RV-crtl/Digital-Hearing-Aid-G1/Documentation/ARCHITECTURE.md

# Integrated firmware architecture and ownership

## Product vs MCU state

This repo contains two *different* notions of mode: the group requirement uses system-wide OFF / STARTUP / NORMAL / SLEEP / FAULT, whereas the portable connectivity policy names its own M1 initialisation, M2 active, M3 source idle, M4 source fault. **M3 source idle is not electrical STOP/SLEEP mode.** Until power-transition hardware is verified, keep those state machines separate.

## Signal flow (current Nucleo integration baseline)

```mermaid
flowchart LR
 BT[Bluetooth receiver / ADC] --> DMA1[SAI1A RX DMA]
 TC[Telecoil frontend / ADC] --> DMA2[SAI2A RX DMA]
 DMA1 --> Q[Bounded PCM capture queues]
 DMA2 --> Q
 Q --> A[AudioTask: transport + DSP]
 A --> OUT[SAI2B TX DMA / amplifier]
 FSM[Portable source FSM] --> A
 CTRL[ControlTask] -->|xQueueSend control events| A
 USER[Nucleo B1] --> CTRL
 A -->|capture occupancy & errors| GUARD[Fixed-memory overload guardian]
 GUARD -->|bypass optional G1 DSP| A
```

Microphone DFSDM, USB audio, charger, custom PCB GPIO, and trained AI are **design candidates**, not running paths here.

## Concurrent responsibilities

| Owner | RTOS mechanism | Shared resource rules |
| --- | --- | --- |
| AudioTask, priority 7 | Audio buffers, time-critical route and optional DSP | Exclusive owner of profile and guardian state; never block on serial output |
| ControlTask, priority 6 | UART commands and `GroupEvent` queue writes | UI/commands send bounded events rather than changing audio state directly |
| Bluetooth supervision, priority 5 | Serial supervision/status | Bluetooth commands must not reconfigure audio DMA behind AudioTask |
| Background, CPULoadB priority 2 | Optional experiment | No real-time ownership; do not enable in production |
| HighLoad7 priority 7 | **20 s disruptive scheduler experiment** | Prohibited in normal hearing-aid use; may starve ControlTask |
| DMA IRQ callbacks | Signal capture/transfer completed | Keep short, bounded; do not do heavy DSP or blocking I/O in interrupts |

**Current limitation:** AudioTask still uses mixed queue-draining / yield logic inherited from R34. The proposed notification-driven architecture is not implemented just by drawing it here. Optimise only against measured CPU load, buffer depth and deadline data, without jeopardising playback.

## Engineering time budget

At `48,000 samples/s`, 128 frames correspond to **2.667 ms** of input time. This is a useful throughput scale, **not an assertion of the exact interrupt service deadline** because the actual buffering and DMA half/full transfers matter. Log worst-case AudioTask time, capture depth, outgoing queue depth, missed deadline counters and speaker underruns while operating the complete system.

## Truthful feature vocabulary

- **Verified:** C unit test, configuration invariant or instrumented hardware result has evidence with environment and thresholds.
- **Validated:** End-to-end user requirement tested on representative assembled hardware.
- **Pending:** Source exists but hardware behavior cannot yet be claimed.
- **Unavailable:** Schematic/PCB lacks the necessary hardware or circuit has unresolved electrical constraints.

Do not call the automatic three-level loudness heuristic 'trained TinyML.' Do not equate software PCM limiting with a safe acoustic SPL. See `Documentation/REQUIREMENTS_EVIDENCE.csv`.
