RV-crtl/Digital-Hearing-Aid-G1/Hardware/STM32_U13_PINMAP.csv

pad | stm32_pin | pcb_net
1 | VBAT_1 | +3V3
2 | PC13_2 | unconnected-(U13-PC13-Pad2)
3 | PC14_3 | unconnected-(U13-PC14-Pad3)
4 | PC15_4 | unconnected-(U13-PC15-Pad4)
5 | RCC_OSC_IN_5 | /Control, Connectivity, and Power/STM32L476RG/HSE_IN
6 | RCC_OSC_OUT_6 | /Control, Connectivity, and Power/STM32L476RG/HSE_OUT
7 | NRST_7 | /Control, Connectivity, and Power/STM32L476RG/~{RST}
8 | I2C3_SCL_8 | /Control, Connectivity, and Power/STM32L476RG/I2C3_SCL
9 | I2C3_SDA_9 | /Control, Connectivity, and Power/STM32L476RG/I2C3_SDA
10 | DFSDM1_CKOUT_10 | /Control, Connectivity, and Power/Audio Input/DFSDM_MIC.CKOUT
11 | SAI1_SD_A_11 | /Control, Connectivity, and Power/Connectivity/SAI1A_CONN.SD
12 | VSSA_12 | GNDA
13 | VDDA_13 | 3.3V_A
14 | PA0_14 | /Control, Connectivity, and Power/STM32L476RG/ROTENC_OUT.A
15 | PA1_15 | /Control, Connectivity, and Power/STM32L476RG/ROTENC_OUT.B
16 | USART2_TX_16 | /Control, Connectivity, and Power/STM32L476RG/USART_TX
17 | USART2_RX_17 | /Control, Connectivity, and Power/STM32L476RG/USART_RX
18 | VSS_18 | GND
19 | VDD_19 | +3V3
20 | PA4_20 | unconnected-(U13-PA4-Pad20)
21 | PA5_21 | unconnected-(U13-PA5-Pad21)
22 | PA6_22 | unconnected-(U13-PA6-Pad22)
23 | PA7_23 | unconnected-(U13-PA7-Pad23)
24 | USART3_TX_24 | /Control, Connectivity, and Power/STM32L476RG/USART3_TX
25 | USART3_RX_25 | /Control, Connectivity, and Power/STM32L476RG/USART3_RX
26 | USART3_CK_26 | /Control, Connectivity, and Power/STM32L476RG/USART3_CK
27 | PB1_27 | unconnected-(U13-PB1-Pad27)
28 | PB2_28 | unconnected-(U13-PB2-Pad28)
29 | SAI1_SCK_A_29 | /Control, Connectivity, and Power/Connectivity/SAI1A_CONN.SCK
30 | PB11_30 | unconnected-(U13-PB11-Pad30)
31 | VSS_31 | GND
32 | VDD_32 | +3V3
33 | SAI2_FS_A_33 | /Control, Connectivity, and Power/Connectivity/SAI1A_CONN.FS
34 | SAI2_SCK_A_34 | /Control, Connectivity, and Power/Connectivity/SAI1A_CONN.SCK
35 | DFSDM1_DATIN2_35 | /Control, Connectivity, and Power/Audio Input/DFSDM_MIC.SD
36 | SAI2_SD_A_36 | /Control, Connectivity, and Power/Connectivity/SAI_CONN_SD
37 | PC6_37 | unconnected-(U13-PC6-Pad37)
38 | PC7_38 | unconnected-(U13-PC7-Pad38)
39 | PC8_39 | unconnected-(U13-PC8-Pad39)
40 | PC9_40 | unconnected-(U13-PC9-Pad40)
41 | PA8_41 | unconnected-(U13-PA8-Pad41)
42 | USART1_TX_42 | /Control, Connectivity, and Power/Connectivity/UART_BT.TX
43 | USART1_RX_43 | /Control, Connectivity, and Power/Connectivity/UART_BT.RX
44 | USB_OTG_FS_DM_44 | /Control, Connectivity, and Power/STM32L476RG/USB_D-
45 | USB_OTG_FS_DP_45 | /Control, Connectivity, and Power/STM32L476RG/USB_D+
46 | SYS_JTMS-SWDIO_46 | /Control, Connectivity, and Power/STM32L476RG/SWDIO
47 | VSS_47 | GND
48 | VDDUSB_48 | +3V3
49 | SYS_JTCK-SWCLK_49 | /Control, Connectivity, and Power/STM32L476RG/SWCLK
50 | SAI2_FS_B_50 | /Control, Connectivity, and Power/Output/SAI_SPEAKER.FS
51 | SAI2_SCK_B_51 | /Control, Connectivity, and Power/Output/SAI_SPEAKER.SCK
52 | PC11_52 | unconnected-(U13-PC11-Pad52)
53 | SAI2_SD_B_53 | /Control, Connectivity, and Power/Output/SAI_SPEAKER.SD
54 | PD2_54 | unconnected-(U13-PD2-Pad54)
55 | SYS_JTDO-SWO_55 | /Control, Connectivity, and Power/STM32L476RG/SWO
56 | PB4_56 | unconnected-(U13-PB4-Pad56)
57 | PB5_57 | unconnected-(U13-PB5-Pad57)
58 | I2C1_SCL_58 | /Control, Connectivity, and Power/STM32L476RG/I2C_CAPTO.SCL
59 | I2C1_SDA_59 | /Control, Connectivity, and Power/STM32L476RG/I2C_CAPTO.SDA
60 | BOOT0_60 | /Control, Connectivity, and Power/STM32L476RG/BOOT0
61 | SAI1_MCLK_A_61 | /Control, Connectivity, and Power/Connectivity/SAI1A_CONN.MCLK
62 | SAI1_FS_A_62 | /Control, Connectivity, and Power/Connectivity/SAI1A_CONN.FS
63 | VSS_63 | GND
64 | VDD_64 | +3V3
