RV-crtl/Digital-Hearing-Aid-G1/docs/assets/g1-assembly.3mf

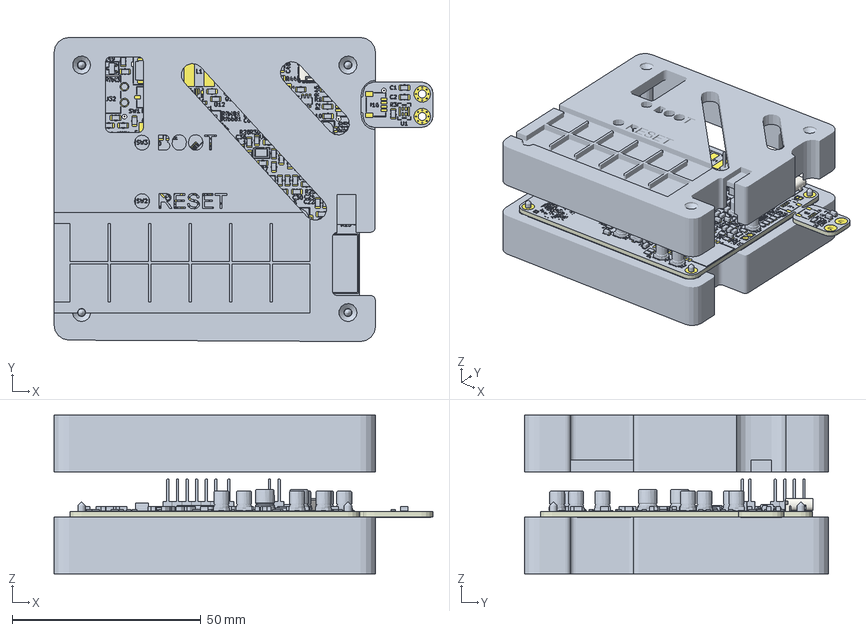
[picture p1: CAD file, 2026-10-31]
docs/assets/g1-assembly.3mf
100.3 x 80.5 x 42.0 mm
Imported_131
Imported_1628
Imported_557
Imported_944
Imported_29
Imported_132
Imported_481
Imported_34
Imported_765
Imported_28
Imported_491
Imported_01
Imported_1682
Imported_1713
Imported_257
Imported_02
Imported_247
Imported_283
Imported_1084
Imported_04
Imported_03
Imported_278
Imported_113
Imported_1071
Imported_1185
Imported_708
Imported_39
Imported_1561
Imported_148
Imported_58
Imported_970
Imported_35
Imported_1033
Imported_586
Imported_297
Imported_14
Imported_05
Imported_06
Imported_870
Imported_839
Imported_42
Imported_1390
Imported_1015
Imported_486
Imported_1188
Imported_36
Imported_75
Imported_252
Imported_1246
Imported_1668
Imported_97
Imported_07
Imported_376
Imported_1243
Imported_907
Imported_20
Imported_1304
Imported_61
Imported_303
Imported_1585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
