RV-crtl/Digital-Hearing-Aid-G1/RESULTS_LOCATION.txt

/mnt/data/work_r34/261013-Individual_Demonstration_Connectivity/RESULTS_R26
