RV-crtl/Digital-Hearing-Aid-G1/Hardware/Original_KiCad/260510-Digital_hearing_aid.kicad_pcb

## KiCad design Hardware/Original_KiCad/260510-Digital_hearing_aid.kicad_pcb (2026-10-15)

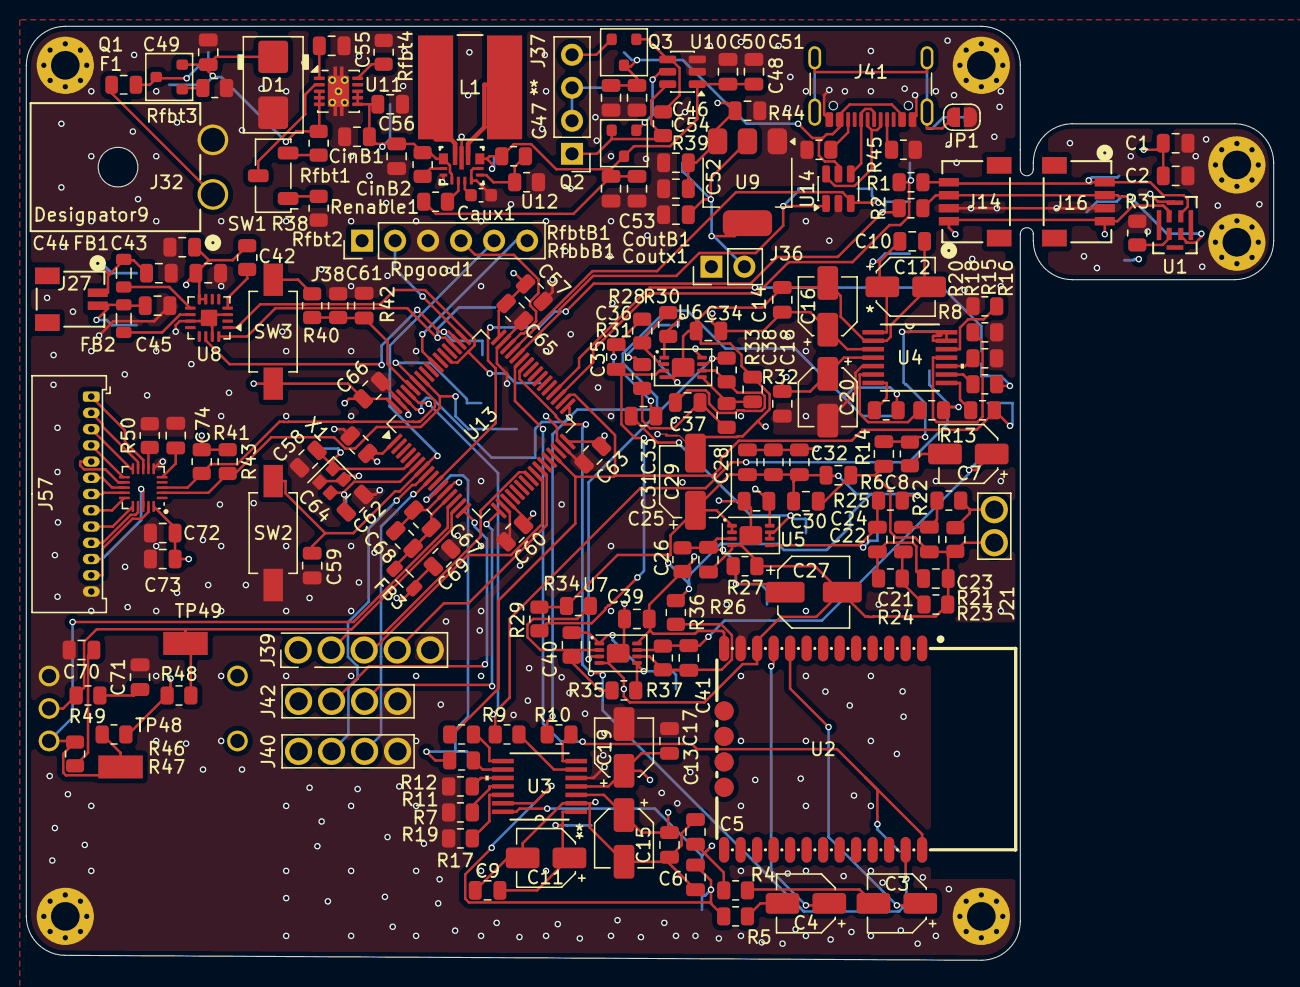
[picture p2: board 260510-Digital_hearing_aid.kicad_pcb from above]

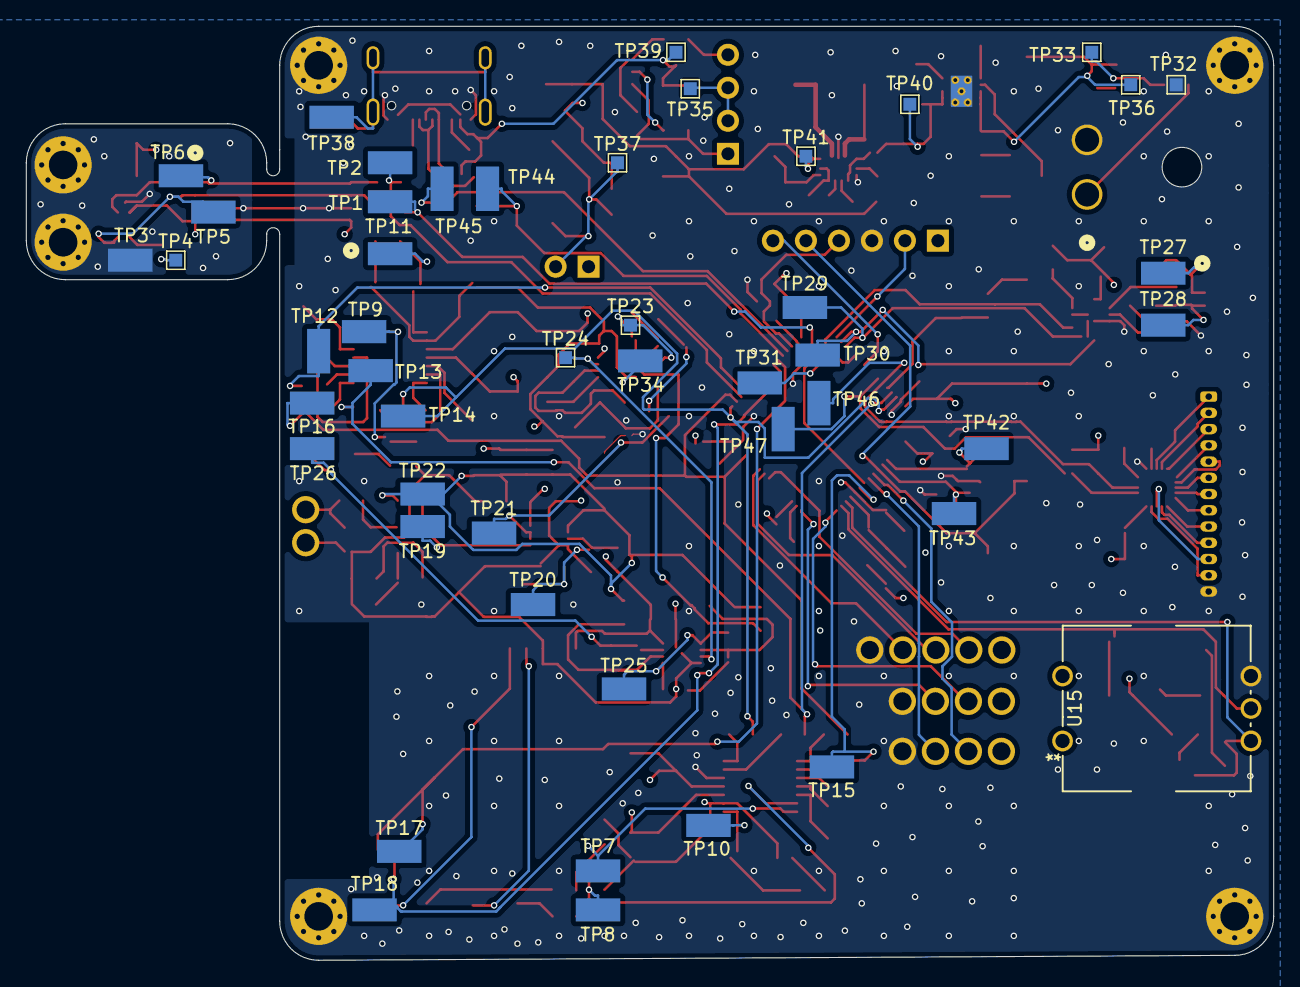
[picture p3: board 260510-Digital_hearing_aid.kicad_pcb from below]

Board: 4 copper layers, 96.0 x 71.9 mm, 236 parts (48 on the bottom side), 134 nets.

Parts:
C1, C42, C46, C50, C57: 10u; C_0805_2012Metric
C2, C9, C10, C13, C14, C17, C18, C25, C26, C28, C30, C31, C32, C33, C34, C39, C43, C47, C49, C51, C54, C59, C60, C61, C63, C64, C65, C66, C72, C73, C74: 100n; C_0805_2012Metric
C3, C4, C7, C11, C12, C15, C16, C19, C20: 10u; CP_Elec_4x5.3
C5, C6, C8: 100p; C_0805_2012Metric
C21, C44, C45: 470p; C_0805_2012Metric
C22: 33n; C_0805_2012Metric
C23, C55: 1n; C_0805_2012Metric
C24, C56, C68, C69: 1u; C_0805_2012Metric
C27, C29: 10u; CP_Elec_5x5.7
C35, C36: 22n; C_0805_2012Metric
C37: 3n; C_0805_2012Metric
C38: 1n5; C_0805_2012Metric
C40, C41: 22p; C_0805_2012Metric
C48, C52: 22u; C_0805_2012Metric
C53: 47u; C_0805_2012Metric
C58, C62: 10p; C_0805_2012Metric
C67, C70, C71: 10n; C_0805_2012Metric
Caux1: 100n; C_0603_1608Metric
CinB1, CinB2: 22u; C_0805_2012Metric
CoutB1: 22u; C_0805_2012Metric
Coutx1: 10u; C_0805_2012Metric
D1: SMBJ8.0A; D_SMB
F1: Fuse; Fuse_0805_2012Metric
FB1, FB2, FB3: 120R @100MHz; L_0805_2012Metric
H1, H2, H3, H4, H5, H6: MountingHole_Pad; MountingHole_2.2mm_M2_Pad_Via
J14, J16: Microphone Connectors; CONN_SM04B-SRSS-TB_JST
J21: Telecoil; PinHeader_01x02_P2.54mm_Vertical_THT_D1.4mm
J27: Bone Conductor Connector; CONN_SM02B-SRSS-TB_JST
J32: 1726480102; CONN_SD-172648-0000_02_MOL
J36: Conn_01x02_Pin; PinHeader_1x02_P2.54mm_Vertical
J37: Conn_01x04_Pin; PinHeader_1x04_P2.54mm_Vertical
J38: ST_LINK; PinHeader_1x06_P2.54mm_Vertical
J39: Number of Lines; PinHeader_01x05_P2.54mm_Vertical_THT_D1.4mm
J40, J42: Impedance @ Frequency; PinHeader_01x04_P2.54mm_Vertical_THT_D1.4mm
J41: USB_C_Receptacle_USB2.0_16P; USB_C_Receptacle_GCT_USB4105-xx-A_16P_TopMnt_Horizontal
J57: Conn_01x13; Molex_PicoBlade_53048-1310_1x13_P1.25mm_Horizontal
JP1: SolderJumper_2_Open; SolderJumper-2_P1.3mm_Open_RoundedPad1.0x1.5mm
L1: 1u5; IND_BOURNS_SDR0805
NT1: NetTie_2; Net_Tie_0.16mm_6mil
Q1, Q2, Q3: AO3419; SOT-23
R1, R2, R30, R33: 33R; R_0805_2012Metric
R3, R4, R5, R6, R7, R8, R17, R18, R19, R20, R24, R34, R36, R40, R41, R43, R46, R47, R48, R49: 10k; R_0805_2012Metric
R9, R10, R11, R12, R13, R14, R15, R16: 100R; R_0805_2012Metric
R21, R25, R38: 100k; R_0805_2012Metric
R22: 1k; R_0805_2012Metric
R23, R35, R37: 47k; R_0805_2012Metric
R26, R27: 22k; R_0805_2012Metric
R28: 21k5; R_0805_2012Metric
R29: 43k; R_0805_2012Metric
R31, R32: 11k7; R_0805_2012Metric
R39: 470k; R_0805_2012Metric
R42: 220R; R_0805_2012Metric
R44, R45: 5k1; R_0805_2012Metric
R50: 75k; R_0805_2012Metric
Renable1: 10k; R_0805_2012Metric
RfbbB1: 100k; R_0805_2012Metric
Rfbt1: 301k; R_0805_2012Metric
Rfbt2, Rfbt3: 100k; R_0805_2012Metric
Rfbt4: 45k3; R_0805_2012Metric
RfbtB1: 523k; R_0805_2012Metric
Rpgood1: 100k; R_0805_2012Metric
SW1: SW_Nidec_CAS-120TA; Nidec_Copal_CAS-120A
SW2, SW3: Switch_Tactile_CnK; Button_CnK_PTS636.0_6x3.5mm
TP1: MicClk1; KEYSTONE_5015
TP2: MicSd1; KEYSTONE_5015
TP3: GND1; KEYSTONE_5015
TP4: Ext3V0; TestPoint_Pad_1.0x1.0mm
TP5: MicClk2; KEYSTONE_5015
TP6: MicSd2; KEYSTONE_5015
TP7: VinR1; KEYSTONE_5015
TP8: VinL1; KEYSTONE_5015
TP9: TcVin1; KEYSTONE_5015
TP10: BtVref_adc1; KEYSTONE_5015
TP11: TcVref_adc1; KEYSTONE_5015
TP12: Sai2SD1; KEYSTONE_5015
TP13: SaiMCLK1; KEYSTONE_5015
TP14: SaiFS1; KEYSTONE_5015
TP15: SaiSD1; KEYSTONE_5015
TP16: SaiSCK1; KEYSTONE_5015
TP17: BtRx1; KEYSTONE_5015
TP18: BtTx1; KEYSTONE_5015
TP19: BuffIn1; KEYSTONE_5015
TP20: Buff+1; KEYSTONE_5015
TP21: BuffOut1; KEYSTONE_5015
TP22: TcVref1; KEYSTONE_5015
TP23: FiltIn1; TestPoint_Pad_1.0x1.0mm
TP24: FiltOut1; TestPoint_Pad_1.0x1.0mm
TP25: TcAmpIn1; KEYSTONE_5015
TP26: TcAmpOut1; KEYSTONE_5015
TP27: Spk+1; KEYSTONE_5015
TP28: Spk-1; KEYSTONE_5015
TP29: SpkCK1; KEYSTONE_5015
TP30: SpkFS1; KEYSTONE_5015
TP31: SpkSD1; KEYSTONE_5015
TP32: BATT-; TestPoint_Pad_1.0x1.0mm
TP33: BATT+; TestPoint_Pad_1.0x1.0mm
TP34: GndA1; KEYSTONE_5015
TP35: 5V; TestPoint_Pad_1.0x1.0mm
TP36: TpsVin1; TestPoint_Pad_1.0x1.0mm
TP37: 3V0; TestPoint_Pad_1.0x1.0mm
TP38: ChassGnd1; KEYSTONE_5015
TP39: VBus1; TestPoint_Pad_1.0x1.0mm
TP40: TpsOut1; TestPoint_Pad_1.0x1.0mm
TP41: BATT5V+1; TestPoint_Pad_1.0x1.0mm
TP42: HseIN1; KEYSTONE_5015
TP43: HseOUT1; KEYSTONE_5015
TP44: UsbD-1; KEYSTONE_5015
TP45: UsbD+1; KEYSTONE_5015
TP46: CaptoSDA1; KEYSTONE_5015
TP47: CaptoSCL1; KEYSTONE_5015
TP48: EncA1; KEYSTONE_5015
TP49: EncB1; KEYSTONE_5015
U1: MP34DT05TR-A; MP34DT05TR-A_STM
U2: DFR0781; COMM-SMD_L23.0-W15.5-P1.27_DFR0781
U3, U4: PCM1808PWR; PW14
U5, U6, U7: MCP6232T-E-MNY; DFN-8-1EP_3x2mm_P0.5mm_EP1.75x1.45mm
U8: MAX98357A; TQFN-16-1EP_3x3mm_P0.5mm_EP1.23x1.23mm
U9: AMS1117-3.3; SOT-223-3_TabPin2
U10: LTC4412ES6#TRMPBF; TSOT-23-6
U11: TPS259260DRCR; VSON-10_Custom
U12: TPS63070RNMR; RNM0015A
U13: STM32L476RGTx; LQFP-64_10x10mm_P0.5mm
U14: USBLC6-2SC6; SOT-23-6
U15: PEC11R-4215F-S0024; TO_215F-S0024
U16: MPR121QR2; QFN-20_3x3mm_P0.4mm
X1: 16MHz; Crystal_SMD_SeikoEpson_FA128-4Pin_2.0x1.6mm

Connections:
3.3V_A: C67.1, C68.1, FB3.1, U13.13 (VDDA)
+3V3: C1.1, C2.1, C17.1, C18.1, C19.1, C20.1, C57.1, C60.1, C63.1, C64.1, C65.1, C66.1, C69.1, C72.1, C73.2, FB3.2, J14.1, J16.4, J36.1, J38.1, J39.1, J40.1, J42.1, R41.1, R43.1, SW3.2, TP4.1 (1_1), U1.1 (VDD), U3.4 (VDD), U4.4 (VDD), U13.1 (VBAT), U13.19 (VDD), U13.32 (VDD), U13.48 (VDDUSB), U13.64 (VDD), U16.20 (VDD)
+5V: C13.1, C14.1, C15.1, C16.1, C25.1, C34.1, C39.1, C42.1, C43.1, C48.2, C53.1, C54.2, J37.2, J37.3, R26.2, R38.1, R46.1, R48.1, TP35.1 (1_1), U2.13 (VCC), U3.3 (VCC), U4.3 (VCC), U5.8 (V+), U6.8 (V+), U7.8 (V+), U8.7 (VDD), U8.8 (VDD), U9.3 (VI)
+5VBAT: C50.1, C51.2, CoutB1.1, Coutx1.1, Q2.3 (D), RfbtB1.1, Rpgood1.1, TP41.1 (1_1), U10.1 (VIN), U12.7 (VOUT), U12.8 (VOUT)
/Control, Connectivity, and Power/Audio Input/DFSDM_CLK: J14.3, J16.2, R2.2, TP5.TP, U1.3 (CLK)
/Control, Connectivity, and Power/Audio Input/DFSDM_DOUT: J14.4, J16.1, R1.2, TP6.TP, U1.4 (DOUT)
/Control, Connectivity, and Power/Audio Input/DFSDM_MIC.CKOUT: R2.1, TP1.TP, U13.10 (DFSDM1_CKOUT)
/Control, Connectivity, and Power/Audio Input/DFSDM_MIC.SD: R1.1, TP2.TP, U13.35 (DFSDM1_DATIN2)
/Control, Connectivity, and Power/Connectivity/Analog Frontend/Active Bandpass 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: C35.1, TP21.TP, U5.6 (-), U5.7
/Control, Connectivity, and Power/Connectivity/Analog Frontend/Active Bandpass 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: R33.1, TP24.1 (1_1), U6.7, U7.3 (+)
/Control, Connectivity, and Power/Connectivity/Analog Frontend/TC+: J21.1, R21.2, R22.2
/Control, Connectivity, and Power/Connectivity/Analog Frontend/TC_DACO: C7.1, C41.2, R37.2, TP26.TP, U7.7
/Control, Connectivity, and Power/Connectivity/Analog Frontend/Telecoil Buffer 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: C24.2, R25.2, TP19.TP, U5.5 (+)
/Control, Connectivity, and Power/Connectivity/BT_BCK: R12.1, U3.8 (BCK)
/Control, Connectivity, and Power/Connectivity/BT_DACL: C4.1, U2.10 (DACL)
/Control, Connectivity, and Power/Connectivity/BT_DACR: C3.1, U2.9 (DACR)
/Control, Connectivity, and Power/Connectivity/BT_DOUT: R11.1, U3.9 (DOUT)
/Control, Connectivity, and Power/Connectivity/BT_FMT: R17.1, U3.12 (FMT)
/Control, Connectivity, and Power/Connectivity/BT_LRCK: R10.1, U3.7 (LRCK)
/Control, Connectivity, and Power/Connectivity/BT_MD0: R7.1, U3.10 (MD0)
/Control, Connectivity, and Power/Connectivity/BT_MD1: R19.1, U3.11 (MD1)
/Control, Connectivity, and Power/Connectivity/BT_SCKI: R9.1, U3.6 (SCKI)
/Control, Connectivity, and Power/Connectivity/BT_VINL: C6.1, R5.2, TP8.TP, U3.13 (VINL)
/Control, Connectivity, and Power/Connectivity/BT_VINR: C5.1, R4.2, TP7.TP, U3.14 (VINR)
/Control, Connectivity, and Power/Connectivity/BT_VREF: C9.1, C11.1, TP10.TP, U3.1 (VREF)
/Control, Connectivity, and Power/Connectivity/SAI1A_CONN.FS: R10.2, R14.2, TP14.TP, U13.33 (SAI2_FS_A), U13.62 (SAI1_FS_A)
/Control, Connectivity, and Power/Connectivity/SAI1A_CONN.MCLK: R9.2, R13.2, TP13.TP, U13.61 (SAI1_MCLK_A)
/Control, Connectivity, and Power/Connectivity/SAI1A_CONN.SCK: R12.2, R16.2, TP16.TP, U13.29 (SAI1_SCK_A), U13.34 (SAI2_SCK_A)
/Control, Connectivity, and Power/Connectivity/SAI1A_CONN.SD: R11.2, TP15.TP, U13.11 (SAI1_SD_A)
/Control, Connectivity, and Power/Connectivity/SAI_CONN_SD: R15.2, TP12.TP, U13.36 (SAI2_SD_A)
/Control, Connectivity, and Power/Connectivity/TC_BCK: R16.1, U4.8 (BCK)
/Control, Connectivity, and Power/Connectivity/TC_DOUT: R15.1, U4.9 (DOUT)
/Control, Connectivity, and Power/Connectivity/TC_FMT: R18.1, U4.12 (FMT)
/Control, Connectivity, and Power/Connectivity/TC_LRCK: R14.1, U4.7 (LRCK)
/Control, Connectivity, and Power/Connectivity/TC_MD0: R8.1, U4.10 (MD0)
/Control, Connectivity, and Power/Connectivity/TC_MD1: R20.1, U4.11 (MD1)
/Control, Connectivity, and Power/Connectivity/TC_SCKI: R13.1, U4.6 (SCKI)
/Control, Connectivity, and Power/Connectivity/TC_VIN: C8.1, R6.2, TP9.TP, U4.13 (VINL), U4.14 (VINR)
/Control, Connectivity, and Power/Connectivity/TC_VREF: C10.1, C12.1, TP11.TP, U4.1 (VREF)
/Control, Connectivity, and Power/Connectivity/UART_BT.RX: TP17.TP, U2.26 (PB0/TX), U13.43 (USART1_RX)
/Control, Connectivity, and Power/Connectivity/UART_BT.TX: TP18.TP, U2.25 (PB1/RX), U13.42 (USART1_TX)
/Control, Connectivity, and Power/Output/OUT+: FB1.1, U8.9 (OUTP)
/Control, Connectivity, and Power/Output/OUT-: FB2.1, U8.10 (OUTN)
/Control, Connectivity, and Power/Output/SAI_SPEAKER.FS: TP30.TP, U8.14 (LRCLK), U13.50 (SAI2_FS_B)
/Control, Connectivity, and Power/Output/SAI_SPEAKER.SCK: TP29.TP, U8.16 (BCLK), U13.51 (SAI2_SCK_B)
/Control, Connectivity, and Power/Output/SAI_SPEAKER.SD: TP31.TP, U8.1 (DIN), U13.53 (SAI2_SD_B)
/Control, Connectivity, and Power/Output/SPEAKER+: C44.2, FB1.2, J27.1, TP27.TP
/Control, Connectivity, and Power/Output/SPEAKER-: C45.2, FB2.2, J27.2, TP28.TP
/Control, Connectivity, and Power/Output/~SD_MODE: R38.2, U8.4 (~SD_MODE)
/Control, Connectivity, and Power/Power/EFUSE_EN: SW1.2 (B), U11.2 (EN/UVLO)
/Control, Connectivity, and Power/Power/VBATT_PROT: C49.1, D1.1 (K), Q1.2 (S), Rfbt1.1, TP36.1 (1_1), U11.3 (VIN), U11.4 (VIN), U11.5 (VIN)
/Control, Connectivity, and Power/STM32L476RG/BOOT0: C61.2, R40.1, R42.1, U13.60 (BOOT0)
/Control, Connectivity, and Power/STM32L476RG/HSE_IN: C58.1, TP42.TP, U13.5 (RCC_OSC_IN), X1.1
/Control, Connectivity, and Power/STM32L476RG/HSE_OUT: C62.2, TP43.TP, U13.6 (RCC_OSC_OUT), X1.3
/Control, Connectivity, and Power/STM32L476RG/I2C3_SCL: J40.2, U13.8 (I2C3_SCL)
/Control, Connectivity, and Power/STM32L476RG/I2C3_SDA: J40.3, U13.9 (I2C3_SDA)
/Control, Connectivity, and Power/STM32L476RG/I2C_CAPTO.SCL: R43.2, TP47.TP, U13.58 (I2C1_SCL), U16.2 (SCL)
/Control, Connectivity, and Power/STM32L476RG/I2C_CAPTO.SDA: R41.2, TP46.TP, U13.59 (I2C1_SDA), U16.3 (SDA)
/Control, Connectivity, and Power/STM32L476RG/ROTENC_OUT.A: R46.2, R47.2, TP48.TP, U13.14 (PA0), U15.A
/Control, Connectivity, and Power/STM32L476RG/ROTENC_OUT.B: R48.2, R49.2, TP49.TP, U13.15 (PA1), U15.B
/Control, Connectivity, and Power/STM32L476RG/SWCLK: J38.2, U13.49 (SYS_JTCK-SWCLK)
/Control, Connectivity, and Power/STM32L476RG/SWDIO: J38.4, U13.46 (SYS_JTMS-SWDIO)
/Control, Connectivity, and Power/STM32L476RG/SWO: J38.6, U13.55 (SYS_JTDO-SWO)
/Control, Connectivity, and Power/STM32L476RG/USART3_CK: J39.4, U13.26 (USART3_CK)
/Control, Connectivity, and Power/STM32L476RG/USART3_RX: J39.3, U13.25 (USART3_RX)
/Control, Connectivity, and Power/STM32L476RG/USART3_TX: J39.2, U13.24 (USART3_TX)
/Control, Connectivity, and Power/STM32L476RG/USART_RX: J42.3, U13.17 (USART2_RX)
/Control, Connectivity, and Power/STM32L476RG/USART_TX: J42.2, U13.16 (USART2_TX)
/Control, Connectivity, and Power/STM32L476RG/USBC_CC1: J41.A5 (CC1), R45.1
/Control, Connectivity, and Power/STM32L476RG/USBC_CC2: J41.B5 (CC2), R44.1
/Control, Connectivity, and Power/STM32L476RG/USBC_D+: J41.A6 (D+), J41.B6 (D+), U14.4 (I/O2)
/Control, Connectivity, and Power/STM32L476RG/USBC_D-: J41.A7 (D-), J41.B7 (D-), U14.6 (I/O1)
/Control, Connectivity, and Power/STM32L476RG/USB_D+: TP45.TP, U13.45 (USB_OTG_FS_DP), U14.3 (I/O2)
/Control, Connectivity, and Power/STM32L476RG/USB_D-: TP44.TP, U13.44 (USB_OTG_FS_DM), U14.1 (I/O1)
/Control, Connectivity, and Power/STM32L476RG/~RST: C59.1, J38.5, SW2.1, U13.7 (NRST)
/Control, Connectivity, and Power/User Interface/CAPTO_REXT: R50.1, U16.7 (REXT)
/Control, Connectivity, and Power/User Interface/CAPTO_VREG: C74.2, U16.5 (VREG)
Chassis GND: J41.SH (SHIELD), JP1.2 (B), TP38.TP
GND: C1.2, C2.2, C17.2, C18.2, C19.2, C20.2, C42.2, C43.2, C44.1, C45.1, C46.2, C47.1, C48.1, C49.2, C50.2, C51.1, C52.2, C53.2, C54.1, C55.2, C56.2, C57.2, C58.2, C59.2, C60.2, C61.1, C62.1, C63.2, C64.2, C65.2, C66.2, C69.2, C70.2, C71.2, C72.2, C73.1, C74.1, Caux1.2, CinB1.2, CinB2.2, CoutB1.2, Coutx1.2, D1.2 (A), H1.1 (1_1), H2.1 (1_1), H3.1 (1_1), H4.1 (1_1), H5.1 (1_1), H6.1 (1_1), J14.2, J16.3, J32.2, J38.3, J39.5, J40.4, J41.A1 (GND), J41.A12 (GND), J41.B1 (GND), J41.B12 (GND), J42.4, J57.13, JP1.1 (A), NT1.1, R3.2, R7.2, R8.2, R17.2, R18.2, R19.2, R20.2, R40.2, R44.2, R45.2, R50.2, RfbbB1.2, Rfbt2.2, Rfbt3.2, Rfbt4.2, SW2.2, TP3.TP, TP32.1 (1_1), U1.5 (GND), U2.12 (GND), U3.5 (DGND), U4.5 (DGND), U8.3 (GND), U8.11 (GND), U8.15 (GND), U8.17 (PAD), U9.1 (GND), U10.2 (GND), U10.3 (CTL), U11.11 (GND), U12.4 (GND), U12.6 (FB2), U12.10 (PGND), U12.15 (VSEL), U13.18 (VSS), U13.31 (VSS), U13.47 (VSS), U13.63 (VSS), U14.2 (GND), U15.C, U16.6 (VSS), X1.2, X1.4
GNDA: C5.2, C6.2, C8.2, C9.2, C10.2, C11.2, C12.2, C13.2, C14.2, C15.2, C16.2, C21.2, C23.2, C25.2, C26.2, C27.2, C28.2, C29.2, C30.2, C31.2, C32.2, C33.2, C34.2, C38.1, C39.2, C67.2, C68.2, J21.2, NT1.2, R21.1, R23.2, R27.1, TP34.TP, U2.11 (SGND), U3.2 (AGND), U4.2 (AGND), U5.4 (V-), U5.9 (PAD), U6.4 (V-), U6.9 (PAD), U7.4 (V-), U7.9 (PAD), U13.12 (VSSA)
unnamed: C3.2, R4.1
unnamed: C4.2, R5.1
unnamed: C7.2, R6.1
unnamed: C21.1, C22.1, R22.1
unnamed: C22.2, R23.1, R24.2
unnamed: C23.1, C24.1, R24.1
unnamed: C35.2, C36.1, R28.2
unnamed: C37.1, R31.1, R32.2
unnamed: C70.1, R47.1
unnamed: C71.1, R49.1
unnamed: F1.1, J32.1
unnamed: C52.1, J36.2, TP37.1 (1_1), U9.2 (VO)
unnamed: J37.1, Q2.2 (S), R39.1, U10.6 (SENSE)
unnamed: J37.4, Q3.2 (S)
unnamed: J57.1, U16.8 (ELE0)
unnamed: J57.2, U16.9 (ELE1)
unnamed: J57.3, U16.10 (ELE2)
unnamed: J57.4, U16.11 (ELE3)
unnamed: J57.5, U16.12 (LED0/ELE4)
unnamed: J57.6, U16.13 (LED1/ELE5)
unnamed: J57.7, U16.14 (LED2/ELE6)
unnamed: J57.8, U16.15 (LED3/ELE7)
unnamed: J57.9, U16.16 (LED4/ELE8)
unnamed: J57.10, U16.17 (LED5/ELE9)
unnamed: J57.11, U16.18 (LED6/ELE10)
unnamed: J57.12, U16.19 (LED7/ELE11)
unnamed: F1.2, Q1.3 (D), TP33.1 (1_1)
unnamed: Q1.1 (G), Rfbt3.1
unnamed: Q2.1 (G), U10.5 (GATE)
unnamed: Q3.1 (G), R39.2, U10.4 (STAT)
unnamed: R30.1, R31.2, TP23.1 (1_1), U6.1
unnamed: R42.2, SW3.1
unnamed: Rfbt1.2, SW1.3 (A)
unnamed: Rfbt2.1, SW1.1 (C)
unnamed: R3.1, U1.2 (LR)
unnamed: C26.1, C27.1, R26.1, R27.2, TP20.TP, U5.3 (+)
unnamed: C36.2, R29.2, U6.3 (+)
unnamed: R28.1, R30.2, U6.2 (-)
unnamed: C38.2, R32.1, U6.5 (+)
unnamed: C37.2, R33.2, U6.6 (-)
unnamed: C40.1, R34.2, R35.1, U7.2 (-)
unnamed: C40.2, R35.2, TP25.TP, U7.1, U7.5 (+)
unnamed: C41.1, R36.2, R37.1, U7.6 (-)
unnamed: Rfbt4.1, U11.10 (ILIM)
unnamed: C55.1, U11.1 (dV/dT)
unnamed: Renable1.2, U12.14 (EN)
unnamed: RfbbB1.1, RfbtB1.2, U12.5 (FB)
unnamed: L1.2, U12.11 (L1)
unnamed: L1.1, U12.9 (L2)
unnamed: Rpgood1.2, U12.2 (PG)
unnamed: C56.1, CinB1.1, CinB2.1, Renable1.1, TP40.1 (1_1), U11.6 (OUT), U11.7 (OUT), U11.8 (OUT), U12.1 (PS_SYNC), U12.12 (VIN), U12.13 (VIN)
unnamed: Caux1.1, U12.3 (VAUX)
TCOIL_VREF: C28.1, C29.1, C30.1, C31.1, C32.1, C33.1, R25.1, R29.1, R34.1, R36.1, TP22.TP, U5.1, U5.2 (-)
VBUS: C46.1, C47.2, J41.A4 (VBUS), J41.A9 (VBUS), J41.B4 (VBUS), J41.B9 (VBUS), Q3.3 (D), TP39.1 (1_1), U14.5 (VBUS)
