RV-crtl/Digital-Hearing-Aid-G1/References/GroupMemberPrototypes/I2C_Touch_Probe/Core/Inc/main.h

#define B1_Pin GPIO_PIN_13
#define B1_GPIO_Port GPIOC
#define ENC_A_Pin GPIO_PIN_0
#define ENC_A_GPIO_Port GPIOA
#define ENC_A_EXTI_IRQn EXTI0_IRQn
#define ENC_B_Pin GPIO_PIN_1
#define ENC_B_GPIO_Port GPIOA
#define ENC_B_EXTI_IRQn EXTI1_IRQn
#define USART_TX_Pin GPIO_PIN_2
#define USART_TX_GPIO_Port GPIOA
#define USART_RX_Pin GPIO_PIN_3
#define USART_RX_GPIO_Port GPIOA
#define LD2_Pin GPIO_PIN_5
#define LD2_GPIO_Port GPIOA
#define TMS_Pin GPIO_PIN_13
#define TMS_GPIO_Port GPIOA
#define TCK_Pin GPIO_PIN_14
#define TCK_GPIO_Port GPIOA
#define SWO_Pin GPIO_PIN_3
#define SWO_GPIO_Port GPIOB
