RV-crtl/Digital-Hearing-Aid-G1/References/GroupMemberPrototypes/I2C_Touch_Probe/Core/Src/main.c

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

/* Includes ------------------------------------------------------------------*/
#include "main.h"

/* USER CODE BEGIN Includes */

#include <stdio.h>

/* USER CODE END Includes */


I2C_HandleTypeDef hi2c1;

UART_HandleTypeDef huart2;


void SystemClock_Config(void);

static void MX_GPIO_Init(void);
static void MX_USART2_UART_Init(void);
static void MX_I2C1_Init(void);

/* USER CODE BEGIN PFP */

void I2C_Scan(void);

/* USER CODE END PFP */

/* USER CODE BEGIN 0 */


/* ============================================================
 * PRINTF -> USART2
 * ============================================================ */

int __io_putchar(int ch)
{
    HAL_UART_Transmit(&huart2,
                      (uint8_t *)&ch,
                      1,
                      HAL_MAX_DELAY);

    return ch;
}


/* ============================================================
 * I2C BUS SCANNER
 * ============================================================ */

void I2C_Scan(void)
{
    HAL_StatusTypeDef result;

    uint8_t devices_found = 0;


    printf("\r\n");
    printf("========================================\r\n");
    printf("            I2C BUS SCANNER\r\n");
    printf("========================================\r\n");

    printf("Scanning addresses 0x08 - 0x77...\r\n");
    printf("\r\n");


    /*
     * Scan the normal 7-bit I2C address range.
     *
     * HAL_I2C_IsDeviceReady() expects the 7-bit
     * address shifted left by one bit.
     */

    for (uint8_t address = 0x08;
         address <= 0x77;
         address++)
    {
        result = HAL_I2C_IsDeviceReady(
                    &hi2c1,
                    (uint16_t)(address << 1),
                    3,
                    20);


        if (result == HAL_OK)
        {
            printf(">>> DEVICE FOUND AT 0x%02X <<<\r\n",
                   address);

            devices_found++;
        }
    }


    printf("\r\n");
    printf("----------------------------------------\r\n");


    if (devices_found == 0)
    {
        printf("NO I2C DEVICES FOUND\r\n");
    }

    else
    {
        printf("SCAN COMPLETE\r\n");

        printf("%u DEVICE(S) FOUND\r\n",
               devices_found);
    }


    printf("----------------------------------------\r\n");
}


/* USER CODE END 0 */


/**
  * @brief  The application entry point.
  * @retval int
  */
int main(void)
{

    /* MCU Configuration--------------------------------------------------------*/


    /*
     * Reset of all peripherals,
     * Initializes Flash interface and SysTick.
     */

    HAL_Init();


    /* Configure the system clock */

    SystemClock_Config();


    /* Initialize all configured peripherals */

    MX_GPIO_Init();

    MX_USART2_UART_Init();

    MX_I2C1_Init();


    /* USER CODE BEGIN 2 */


    /*
     * Allow power rails and peripherals
     * to settle before scanning.
     */

    HAL_Delay(500);


    printf("\r\n");
    printf("========================================\r\n");
    printf("              PCB I2C TEST\r\n");
    printf("========================================\r\n");


    /*
     * Run the I2C scanner once.
     */

    I2C_Scan();


    printf("\r\n");
    printf("I2C scan finished.\r\n");
    printf("Press RESET to scan again.\r\n");


    /* USER CODE END 2 */


    /* Infinite loop */

    /* USER CODE BEGIN WHILE */

    while (1)
    {
        HAL_StatusTypeDef result;

        result = HAL_I2C_IsDeviceReady(&hi2c1,
                                       (0x5A << 1),
                                       1,
                                       100);

        if (result == HAL_OK)
        {
            printf("0x5A ACK\r\n");
        }
        else
        {
            printf("0x5A NO ACK\r\n");
        }

        HAL_Delay(100);
    }

    /* USER CODE END WHILE */


}


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
