RV-crtl/Digital-Hearing-Aid-G1/Core/Src/usart.c

#include "usart.h"

UART_HandleTypeDef huart1;
UART_HandleTypeDef huart2;

void MX_USART1_UART_Init(void)
{
  huart1.Instance = USART1;
  huart1.Init.BaudRate = 115200;
  huart1.Init.WordLength = UART_WORDLENGTH_8B;
  huart1.Init.StopBits = UART_STOPBITS_1;
  huart1.Init.Parity = UART_PARITY_NONE;
  huart1.Init.Mode = UART_MODE_TX_RX;
  huart1.Init.HwFlowCtl = UART_HWCONTROL_NONE;
  huart1.Init.OverSampling = UART_OVERSAMPLING_16;
  huart1.Init.OneBitSampling = UART_ONE_BIT_SAMPLE_DISABLE;
  huart1.AdvancedInit.AdvFeatureInit = UART_ADVFEATURE_NO_INIT;
  if (HAL_UART_Init(&huart1) != HAL_OK) Error_Handler();
}

void MX_USART2_UART_Init(void)
{
  huart2.Instance = USART2;
  huart2.Init.BaudRate = 115200;
  huart2.Init.WordLength = UART_WORDLENGTH_8B;
  huart2.Init.StopBits = UART_STOPBITS_1;
  huart2.Init.Parity = UART_PARITY_NONE;
  huart2.Init.Mode = UART_MODE_TX_RX;
  huart2.Init.HwFlowCtl = UART_HWCONTROL_NONE;
  huart2.Init.OverSampling = UART_OVERSAMPLING_16;
  huart2.Init.OneBitSampling = UART_ONE_BIT_SAMPLE_DISABLE;
  huart2.AdvancedInit.AdvFeatureInit = UART_ADVFEATURE_NO_INIT;
  if (HAL_UART_Init(&huart2) != HAL_OK) Error_Handler();
}

void HAL_UART_MspInit(UART_HandleTypeDef *uartHandle)
{
  GPIO_InitTypeDef GPIO_InitStruct = {0};
  RCC_PeriphCLKInitTypeDef PeriphClkInit = {0};

  if (uartHandle->Instance == USART1)
  {
    /* PCB BT401 control path: PA9 USART1_TX -> BT401 RX,
       PA10 USART1_RX <- BT401 TX. */
    PeriphClkInit.PeriphClockSelection = RCC_PERIPHCLK_USART1;
    PeriphClkInit.Usart1ClockSelection = RCC_USART1CLKSOURCE_PCLK2;
    if (HAL_RCCEx_PeriphCLKConfig(&PeriphClkInit) != HAL_OK) Error_Handler();

    __HAL_RCC_USART1_CLK_ENABLE();
    __HAL_RCC_GPIOA_CLK_ENABLE();
    GPIO_InitStruct.Pin = GPIO_PIN_9 | GPIO_PIN_10;
    GPIO_InitStruct.Mode = GPIO_MODE_AF_PP;
    GPIO_InitStruct.Pull = GPIO_NOPULL;
    GPIO_InitStruct.Speed = GPIO_SPEED_FREQ_VERY_HIGH;
    GPIO_InitStruct.Alternate = GPIO_AF7_USART1;
    HAL_GPIO_Init(GPIOA, &GPIO_InitStruct);

    /* Interrupt-driven RX is required: polling every RTOS tick loses burst UART bytes. */
    HAL_NVIC_SetPriority(USART1_IRQn, 6, 0);
    HAL_NVIC_EnableIRQ(USART1_IRQn);
  }
  else if (uartHandle->Instance == USART2)
  {
    /* Primary PC serial console through the NUCLEO ST-LINK/V2-1 Virtual COM Port.
       With NUCLEO SB13/SB14 open and CN3 used as the VCP breakout:
         custom PA2 / USART2_TX -> NUCLEO CN3 RX
         custom PA3 / USART2_RX <- NUCLEO CN3 TX
       Keep a common ground between the NUCLEO and the custom board. */
    PeriphClkInit.PeriphClockSelection = RCC_PERIPHCLK_USART2;
    PeriphClkInit.Usart2ClockSelection = RCC_USART2CLKSOURCE_PCLK1;
    if (HAL_RCCEx_PeriphCLKConfig(&PeriphClkInit) != HAL_OK) Error_Handler();

    __HAL_RCC_USART2_CLK_ENABLE();
    __HAL_RCC_GPIOA_CLK_ENABLE();
    GPIO_InitStruct.Pin = GPIO_PIN_2 | GPIO_PIN_3;
    GPIO_InitStruct.Mode = GPIO_MODE_AF_PP;
    GPIO_InitStruct.Pull = GPIO_NOPULL;
    GPIO_InitStruct.Speed = GPIO_SPEED_FREQ_VERY_HIGH;
    GPIO_InitStruct.Alternate = GPIO_AF7_USART2;
    HAL_GPIO_Init(GPIOA, &GPIO_InitStruct);

    /* R23: USART2 command RX must pre-empt the SAI DMA callbacks so a PC
       command byte is not lost during continuous audio.  Priority 4 is above
       configLIBRARY_MAX_SYSCALL_INTERRUPT_PRIORITY (5), which is safe here
       because the USART2 ISR/callback uses only the lock-free byte ring and
       calls no FreeRTOS API. */
    HAL_NVIC_SetPriority(USART2_IRQn, 4, 0);
    HAL_NVIC_EnableIRQ(USART2_IRQn);

  }
}

void HAL_UART_MspDeInit(UART_HandleTypeDef *uartHandle)
{
  if (uartHandle->Instance == USART1)
  {
    HAL_NVIC_DisableIRQ(USART1_IRQn);
    __HAL_RCC_USART1_CLK_DISABLE();
    HAL_GPIO_DeInit(GPIOA, GPIO_PIN_9 | GPIO_PIN_10);
  }
  else if (uartHandle->Instance == USART2)
  {
    HAL_NVIC_DisableIRQ(USART2_IRQn);
    __HAL_RCC_USART2_CLK_DISABLE();
    HAL_GPIO_DeInit(GPIOA, GPIO_PIN_2 | GPIO_PIN_3);
  }
}
