RV-crtl/Digital-Hearing-Aid-G1/Recovery/Core/Src/dma.c

#include "dma.h"
void MX_DMA_Init(void)
{
  __HAL_RCC_DMA1_CLK_ENABLE();
  __HAL_RCC_DMA2_CLK_ENABLE();
  HAL_NVIC_SetPriority(DMA1_Channel6_IRQn, 5, 0);
  HAL_NVIC_EnableIRQ(DMA1_Channel6_IRQn);
  HAL_NVIC_SetPriority(DMA2_Channel1_IRQn, 5, 0);
  HAL_NVIC_EnableIRQ(DMA2_Channel1_IRQn);
}
