RV-crtl/Digital-Hearing-Aid-G1/(commit log)

2026-10-15 Stage hash-verified G1 STM32CubeIDE firmware and hardware source archive
2026-10-15 Import G1 integrated STM32CubeIDE firmware, tests and PCB
2026-10-16 G4 engineering candidate: documented, host-tested STM32 hearing-aid firmware
    Promote the G1/G2/G3/G4 source, RTOS ownership notes, DSP fast path, mathematical validation, KiCad design source, GitHub presentation and CI. This is a host-tested Nucleo-L476RG engineering candidate; ARM build, acoustic performance and custom-board electrical validation remain open gates. Original G1 baseline archived before merge.
2026-10-16 G5: event-driven DMA audio and standalone debounced multi-gesture UI
2026-10-16 G5: polished product landing page, standalone UX instructions and RTOS validation ladder
2026-10-16 G5: avoid redundant status LED HAL writes in ControlTask
2026-10-19 G6: add HD rubric gates, complete black-box test framework and viva/mechanical guides
2026-10-19 G7: HD engineering consolidation, evidence-integrity gates and one-command automation (#10)
    * G6: rubric-aligned HD system requirements, 19.5-min black-box plan, A3 and viva generator
    * G6: default operating image excludes dummy stress tasks and lab self-test commands
    * G7: correct bidirectional rubric coverage and optional-task startup accounting
    * G7: add cross-platform quality runner, evidence integrity audit and one-click G1 bundle
    * G7: fail-closed evidence mutation tests, Windows CI bundle smoke and portable benchmark timing
    * G7: add fail-closed STM32CubeIDE headless ARM Clean/Build script
    * G7: wire optional CubeIDE ARM headless build and refresh outdated import guidance
    * fix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
2026-10-19 G8: public-source hardening, isolated dashboard, expanded regressions (#12)
    Verified host builds and tests under GCC/Clang and ASan/UBSan, source audit, privacy-safe dashboard paths, isolated Python setup, third-party/rightsholder publication gate. No new claim of clinical/PCB certification. PD5 untouched.
2026-10-20 G9: verify entire source tree, build reports and evidence artifacts (#13)
    Expanded portable-C compilation; all Markdown path and case-collision checks; full PowerShell parsing; current-run ARM ELF revision/SHA evidence integrity; archive manifest and hash verification; mutation tests; documented remaining KiCad and physical test dependencies. G1 only, PD5 unchanged.
2026-10-27 G10: interactive GitHub Pages G1 visual design laboratory (#14)
    Beautiful responsive visual showcase: rotating/explodable CAD-ready WebGL model viewer with privacy-preserving local GLB import; interactive signal architecture; original KiCad sheets export to SVG via opt-in Pages workflow; real GitHub C source explorer; site-specific validation CI. G1 firmware and PD5 untouched. Pages activation/actual CAD upload remain user controlled.
2026-10-27 G10.1: KiCad 10 real schematic gallery + 3D asset upload destination (#15)
    Validated and tested true KiCad 10 SVG rendering for original G1 hierarchy; normalize inline PNGs and preserve page identity; add CAD assets upload directory, native schematic CI smoke and workflow installation fixes. No firmware or PD5 changes.
2026-10-27 G10.2: deduplicate KiCad 10 schematic SVGs for G1 Visual Lab (#16)
    One original native SVG per sheet (verified 15 unique); prefer canonical KiCad hierarchy; map Mid-Supply correctly; reduce publication asset size; refuse duplicate/missing source plot names in site/deploy CI. G1 firmware and PD5 unchanged.
2026-10-27 G10: load original 3MF interactively in GitHub Pages (#17)
    Extend existing 3D visual lab to parse local 3MF assemblies without uploading model data; preserve GLB viewer and fallback; update site validation and model documentation. Both site checks and firmware CI green. PD5 untouched.
2026-10-27 G11: custom-PCB systems atlas, adaptive features, rubric evidence and source candidate (#20)
    Implement interactive full-system website architecture, A3 print view, 2S LiFePO4 target, PDM microphone integration map, tested portable Goertzel scene features and bounded preference learner, source candidates and Dependabot. Repair shell runner, track hardware/AI/GLB publication gates. Both engineering and visual GitHub Actions green. PD5 untouched.
2026-10-31 Integrate R20 physical controls, regression tests and recovery sources
    Import tested R20 UI policy with Anna E8-E11 mapping, configurable quadrature decoder and CRLF volume parser fix. Preserve CubeMX recovery mirrors and legacy audio/PCB documentation. Full R20 board driver remains a separately tested artifact; no claim of complete on-board runtime parity.
2026-10-31 fix: repair G1 CAD viewer, CI audits and current firmware documentation
    * fix: restore authentic 3MF viewer, repair CI audits and clarify PCB status
    * docs: align site guide and candidate archive with authentic 3MF
2026-10-31 feat: publish optimized authentic G1 CAD with 3MF fallback
2026-11-03 feat: rebuild G1 repository, original CAD/KiCad site and current demonstration evidence
    * docs: replace obsolete Nucleo diagrams and demo claims with current G1 PCB architecture and black-box plan
    * feat(web): add native KiCad PCB front/back copper explorer and read-only Pages render pipeline
    * feat(site): redesign CAD, KiCad PCB and demo sections around current custom-PCB evidence
    * feat(site): synchronize actual microphone/telecoil signal maps, ML status and accessible PCB styles
    * feat(cad): remove fictional model geometry; fit full multi-body assemblies, inspect source mesh names and manage WebGL resources
    * test: enforce live G1 system requirements, native KiCad viewer and truthful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
2026-11-03 fix: make G1 website real, align assessment and repair CAD/Pages builds
    * fix(assessment): one canonical custom-PCB 9-requirement, 7-test plan with strict evidence mapping
    * fix(demo): replace legacy Nucleo PDF poster, current assessment guide and black-box traceability
    * fix(assessment): report duplicate test IDs before plan-length failures
    * feat(site): ship real architecture SVG and source-backed interactive seven-test demo runner
    * fix(pages): auto-build actual site, downloadable full preview and strict generated-asset/assessment parity checks
    * docs: remove stale Nucleo B1 rehearsal instruction and explain real source-backed site assets
    * fix(site-build): install required trimesh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
2026-11-05 chore: remove recovery project and duplicate prototype firmware trees
2026-11-05 ci: provide downloadable clean STM32CubeIDE project artifact
2026-11-05 docs: expand R26 guide into 39-event boot-to-output execution trace with annotated code
2026-11-06 docs: add subsystem index preserving complete R26.10 runtime event flow
2026-11-06 docs: explain Ryan BT401 UART, SAI capture, TC recovery and source FSM in runtime order
2026-11-06 docs: trace Naomi SAI2B DMA output, PCM FIFO, volume and underrun handling
2026-11-06 docs: mark release-only board driver rather than linking to unavailable old-branch file
