RV-crtl/Digital-Hearing-Aid-G1/(notices)

Notices in the files:
References/GroupMemberPrototypes/I2C_Touch_Probe/Core/Inc/main.h:
Copyright (c) 2026 STMicroelectronics.
All rights reserved.
This software is licensed under terms that can be found in the LICENSE file
